jwattsphilly/CE-Senior-Project/README.md

# CE-Senior-Project

Project: Heat map technology for a microwave oven

Authors of this project:
James Watts,
Stuart Johnsen,
Darin Stoker
