jwattsphilly/CE-Senior-Project/Final Report Turnin - Team Smart Microwave/Other Files/Thermal Microwave Presentation.pdf

## A SMARTER MICROWAVE

Stuart Johnsen, Darin Stoker, James Watts

## INTRODUCTION

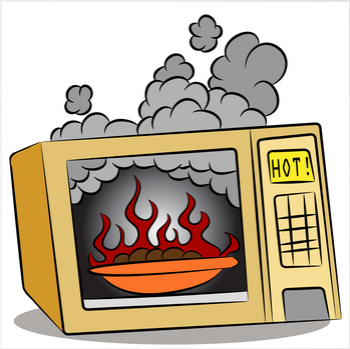
[picture p18: figure]

- Age Old Problem: Lava
Cheese Outside, Ice Cube
in Center
- Old Solution: Nuke it!
- We need a new solution…

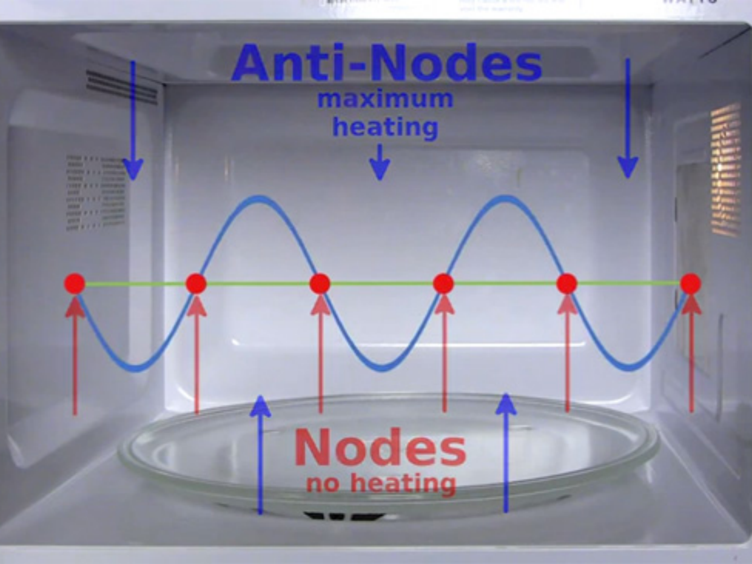
[picture p19: page 3]
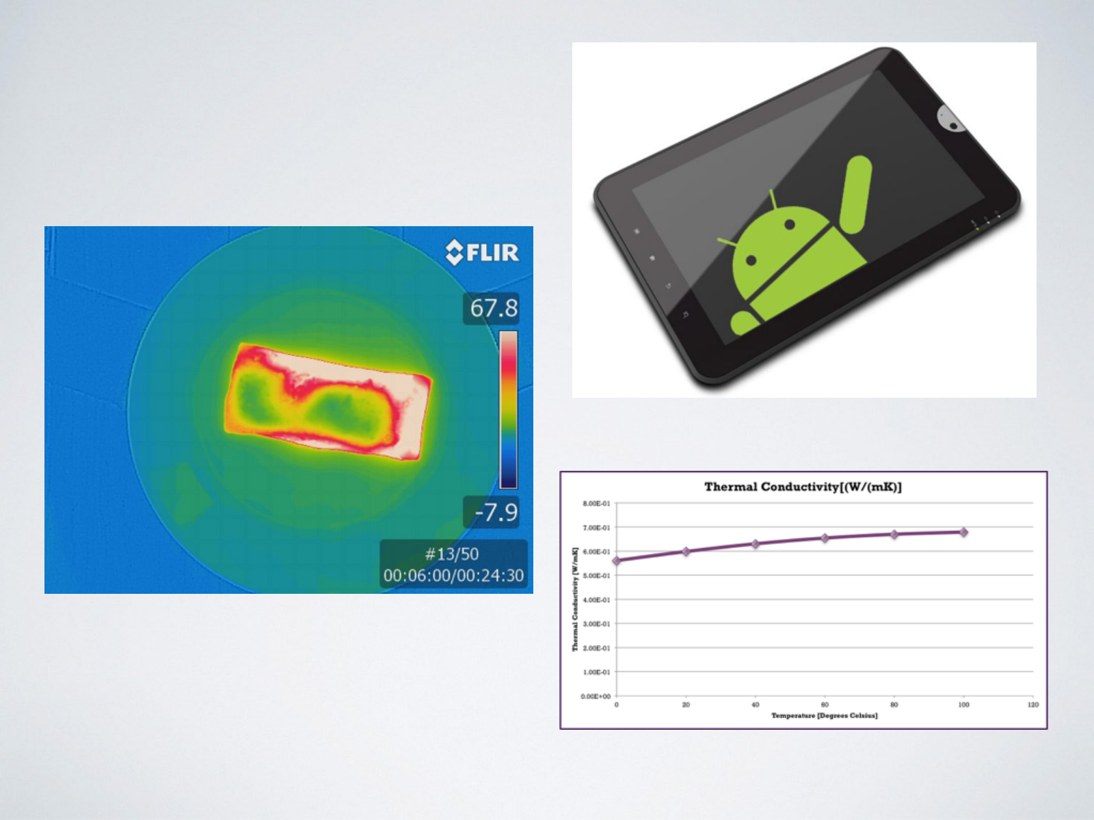
[picture p20: page 4]

## EQUIPMENT NEEDED

- Microwave Oven
- Android Tablet
- Android Studio
- Arduino
- Android-to-Arduino Bridge
- Thermal Camera

## GOAL

- Alter a store-bought microwave so that it can be computer controlled.

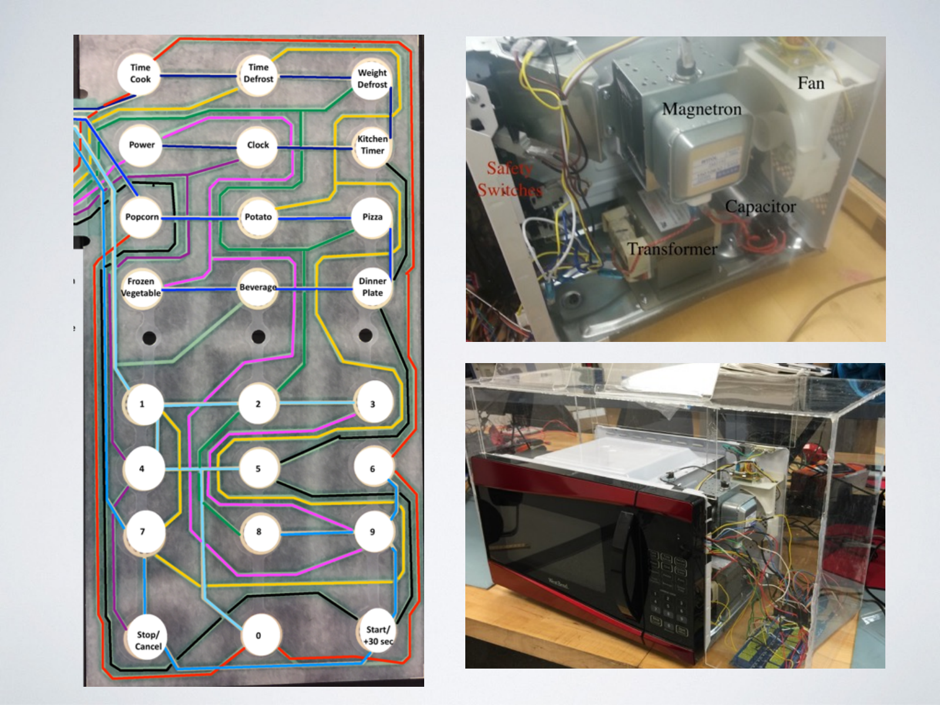
[picture p21: page 7]

## GOAL

- Alter a store-bought microwave so that it can be computer controlled.
- Use UPC (Universal Product Code) scanning to let the microwave know the type of food automatically.

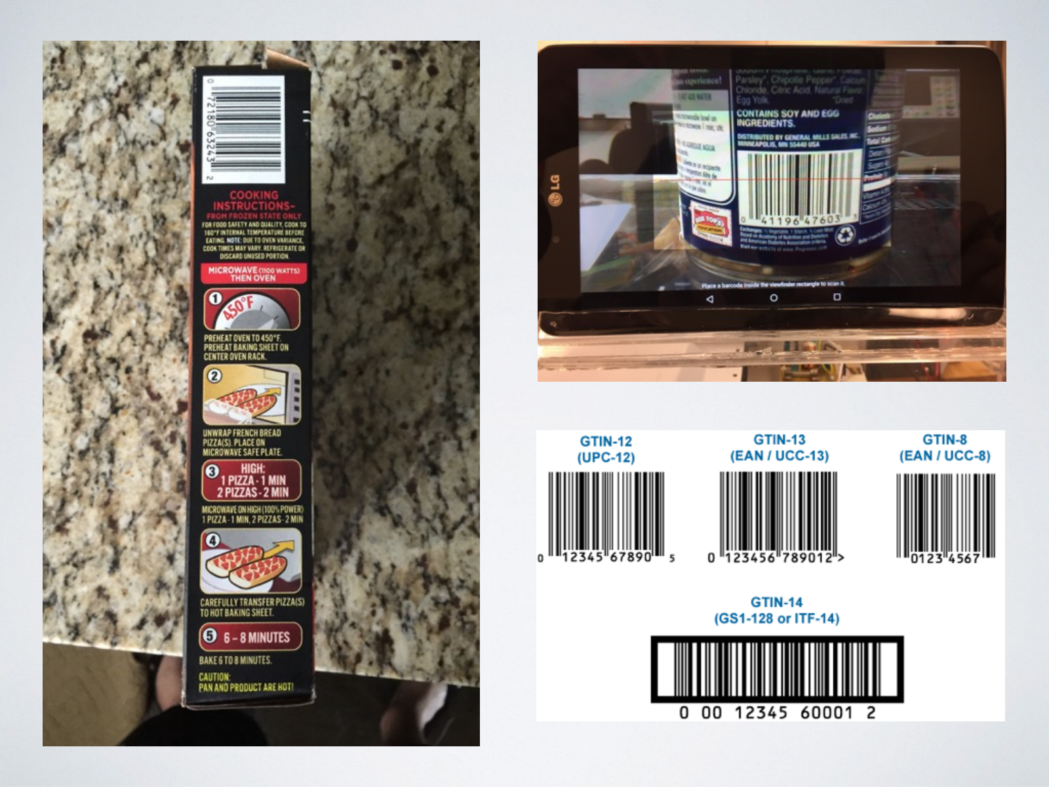
[picture p22: page 9]

## GOAL

- Alter a store-bought microwave so that it can be computer controlled.
- Use UPC (Universal Product Code) scanning to let the microwave know the type of food automatically.
- Actively update a database of food cooking instructions query-able by the microwave.

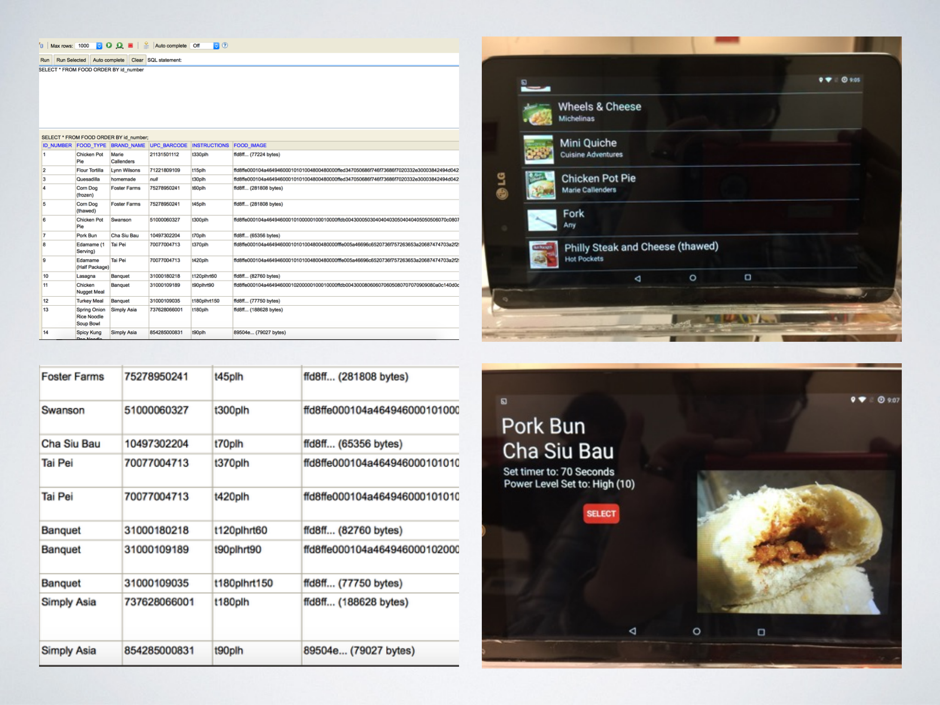
[picture p23: page 11]

## BUT WHAT HAPPENED TO THE THERMAL CAMERA?!?

- A Software Development Kit (SDK) was promised in the summer, but it still hasn’t been delivered.
- Without the camera no live temperature data is available.

## MICROWAVE DEMO

## QUESTIONS?
