jwattsphilly/CE-Senior-Project/Final Report Turnin - Team Smart Microwave/Latex Files/MicrowavePatent.pdf

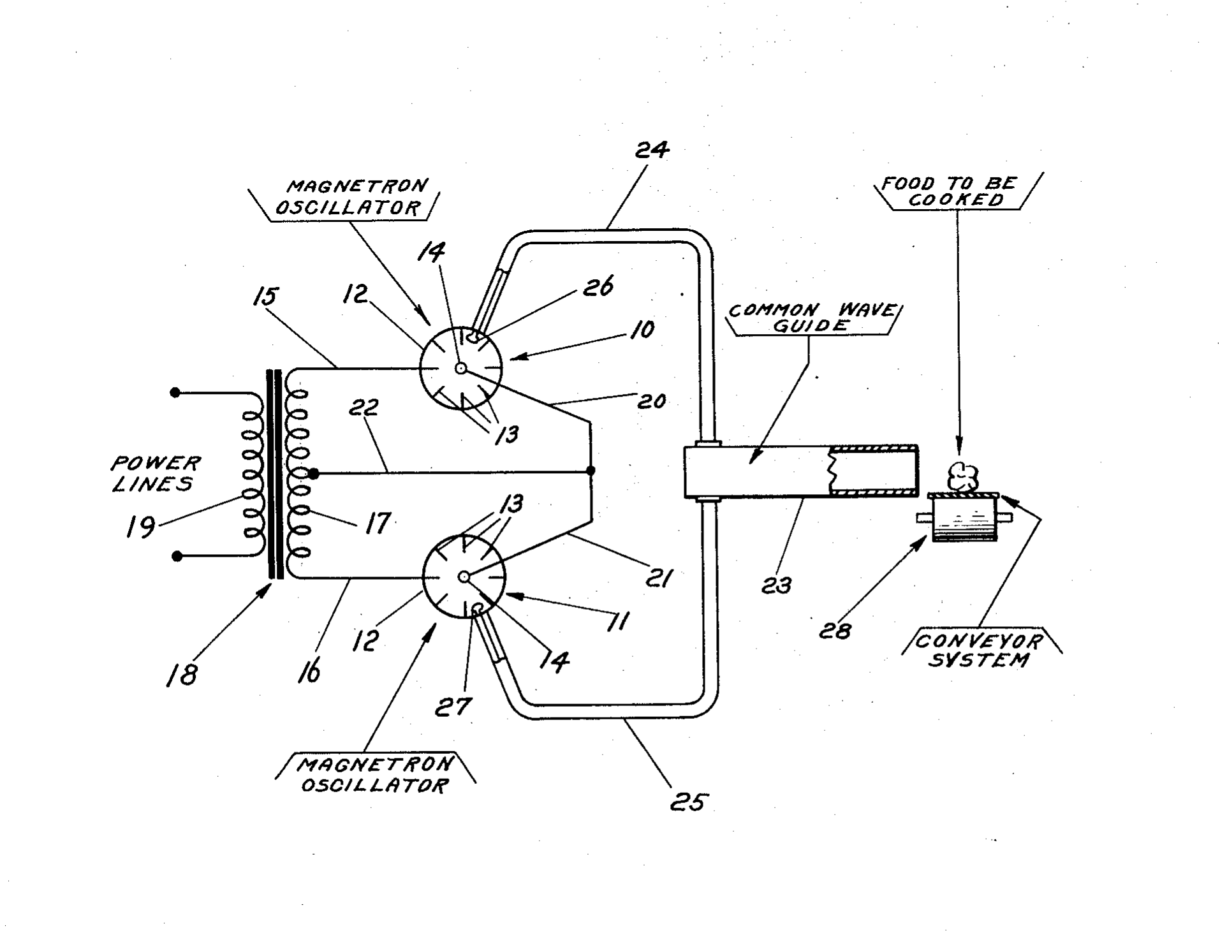
[picture p24: page 1]
