jwattsphilly/CE-Senior-Project/Final Report Turnin - Team Smart Microwave/Other Files/Survey Stats.xlsx

First Review:
Functionality | Satisfaction with Results | User Interface | Overall Satisfaction | Would Want for Oneself | Recommendations |  | Comments
10 | 10 | 10 | 10 | 10 | Thermal Imaging/Image Processing | 6 | Very/Really Cool/Awesome | 4
9 | 9 | 10 | 8 | 3 | User preference/control | 4 | Good Work / Great Job | 3
8 | 6 | 9 | 7 | 5 | Wireless connection / bluetooth | 4 | Great Idea | 3
10 | 10 | 9 | 10 | 8 | Combine touch pad w/ microwave | 2 | Quiche doesn't fare well in microwave | 1
10 | 10 | 10 | 10 | 10 | Quantities of food | 2 | Barcode scanning was cool | 1
9 | 10 | 10 | 10 | 9 | Interface w/ phone - notifications | 2 | Usually don't have barcode | 1
10 | 10 | 10 | 10 | 10 | Altitude, Barometric pressure | 2 | How does thermal imaging improve overall users needs? | 1
9 | 9 | 9 | 9 | 9 | Multiple cooking options | 1 | Practical | 1
10 | 10 | 10 | 10 | 10 | Leaving comments/ratings | 1 | No problems | 1
8 | 8 | 7 | 8 | 6 | Put food in microwave for you | 1 | Wouldn't want to pay a lot more for this functionality | 1
7 | 9 | 10 | 10 | 6 | Show partial search results | 1
9 | 9 | 7 | 9 | 10 | Better looking app | 1
10 | 8 | 10 | 9 | 7 | Nutrition facts | 1
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
