jwattsphilly/CE-Senior-Project/App Design.JPG

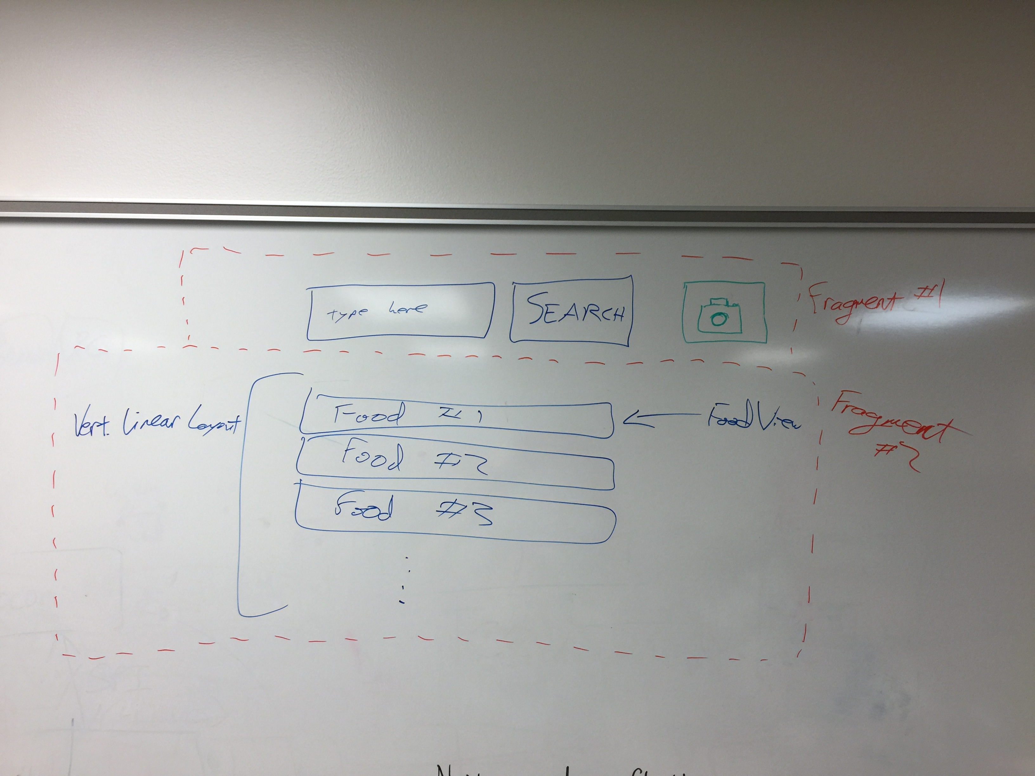
App Design.JPG
