jwattsphilly/CE-Senior-Project/Final Report Turnin - Team Smart Microwave/Latex Files/Microwave_Motor_1.jpg

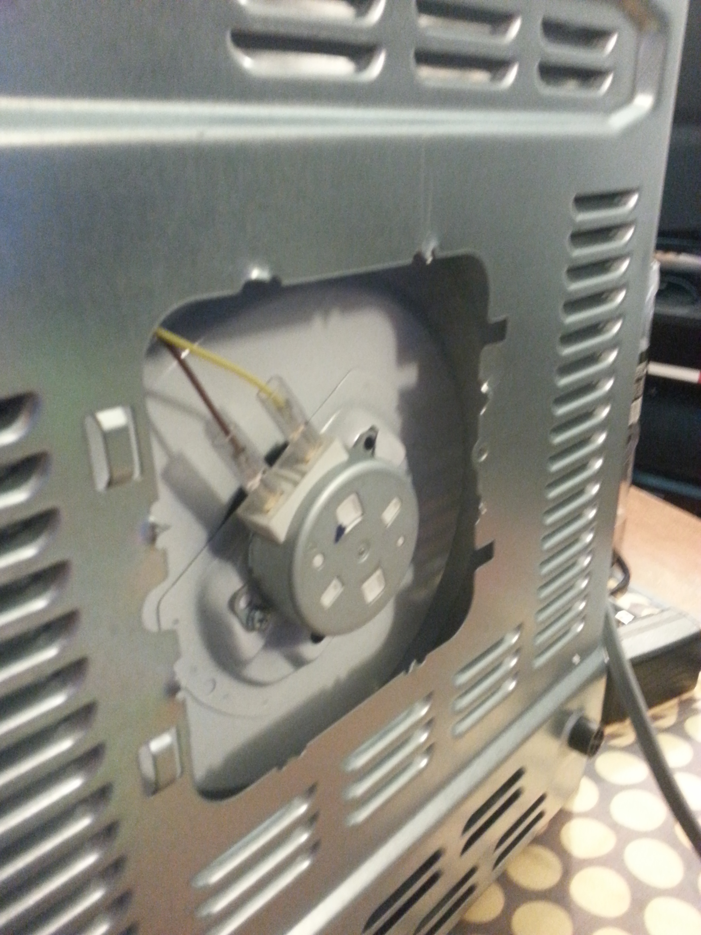
Final Report Turnin - Team Smart Microwave/Latex Files/Microwave_Motor_1.jpg
