jwattsphilly/CE-Senior-Project/Microcontroller Pinout.png

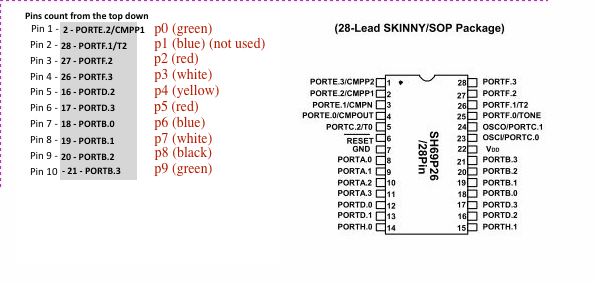
Microcontroller Pinout.png
