jwattsphilly/CE-Senior-Project/Microwave Activity Map.jpg

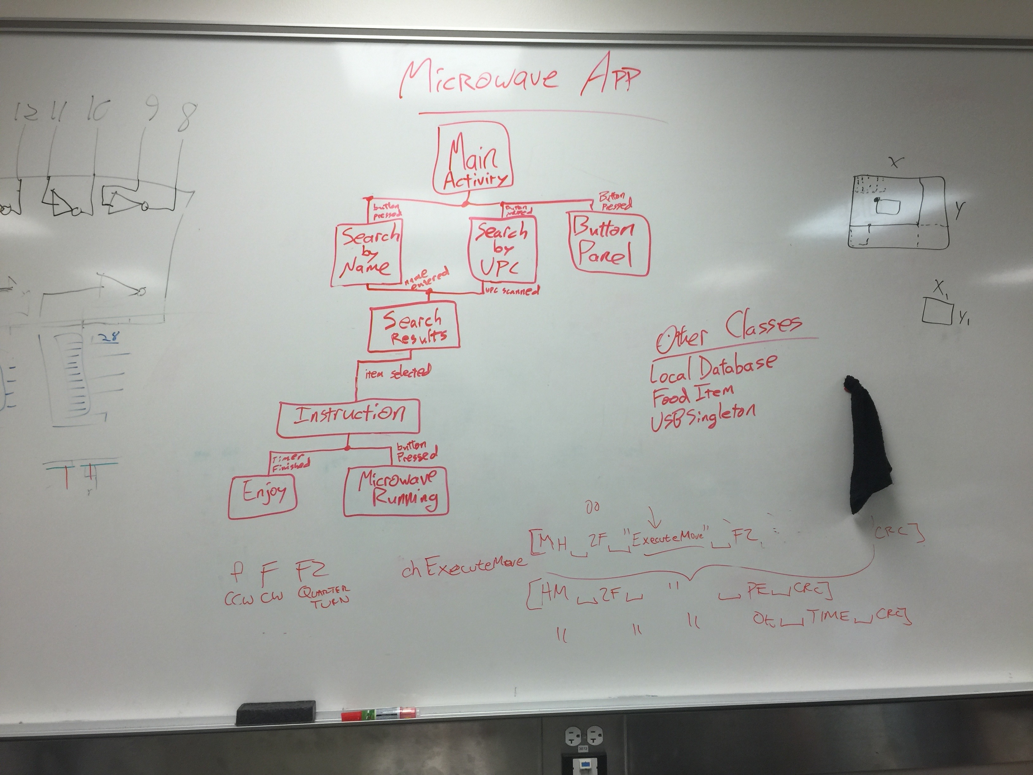
Microwave Activity Map.jpg
