jwattsphilly/CE-Senior-Project/Audio data transfer/Instructable/tek00000.png

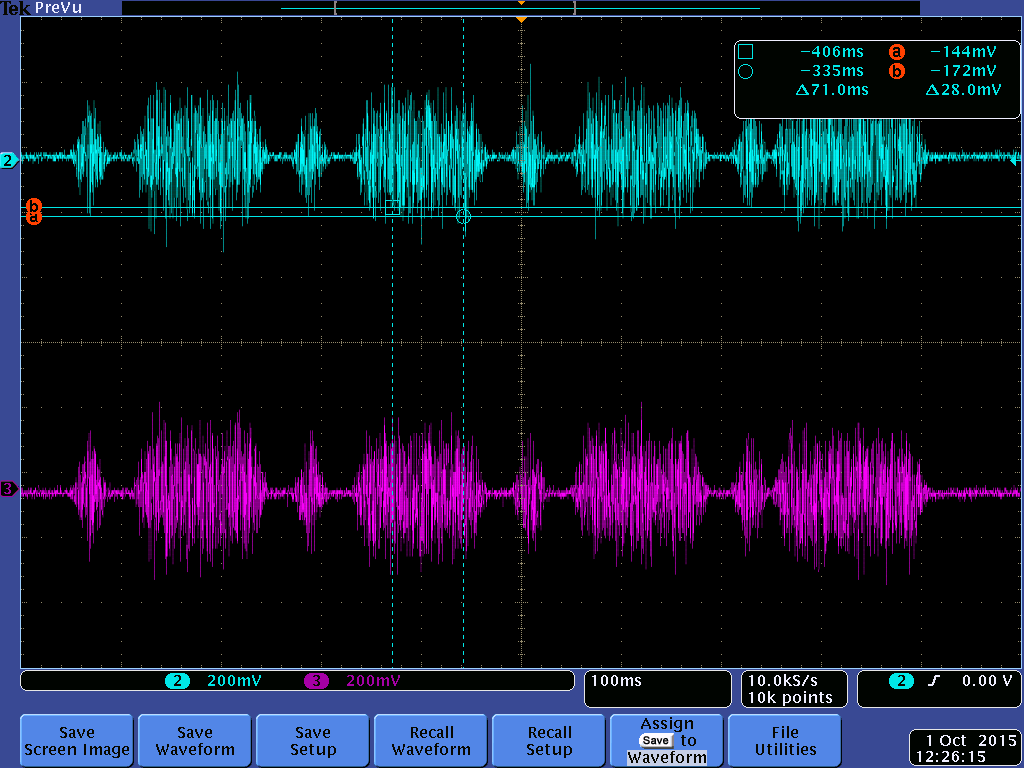
Audio data transfer/Instructable/tek00000.png
