jwattsphilly/CE-Senior-Project/Final Report Turnin - Team Smart Microwave/Construction Images/Arduino and Relay Board.jpg

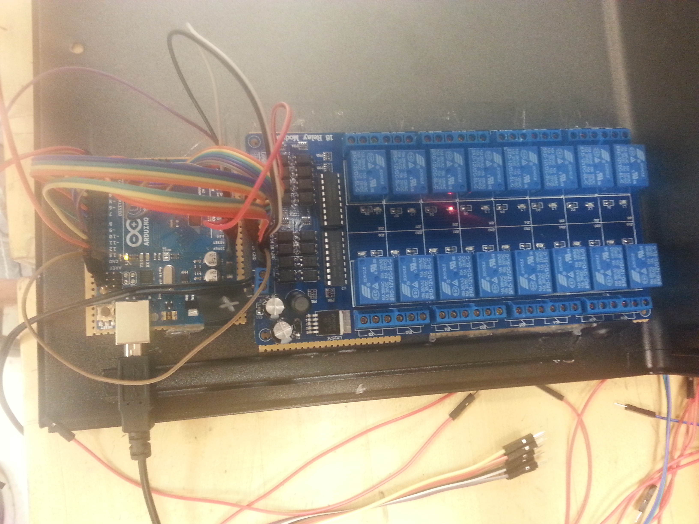
Final Report Turnin - Team Smart Microwave/Construction Images/Arduino and Relay Board.jpg
