jwattsphilly/CE-Senior-Project/Final Report Turnin - Team Smart Microwave/Construction Images/Microwave Motor Bottom.jpg

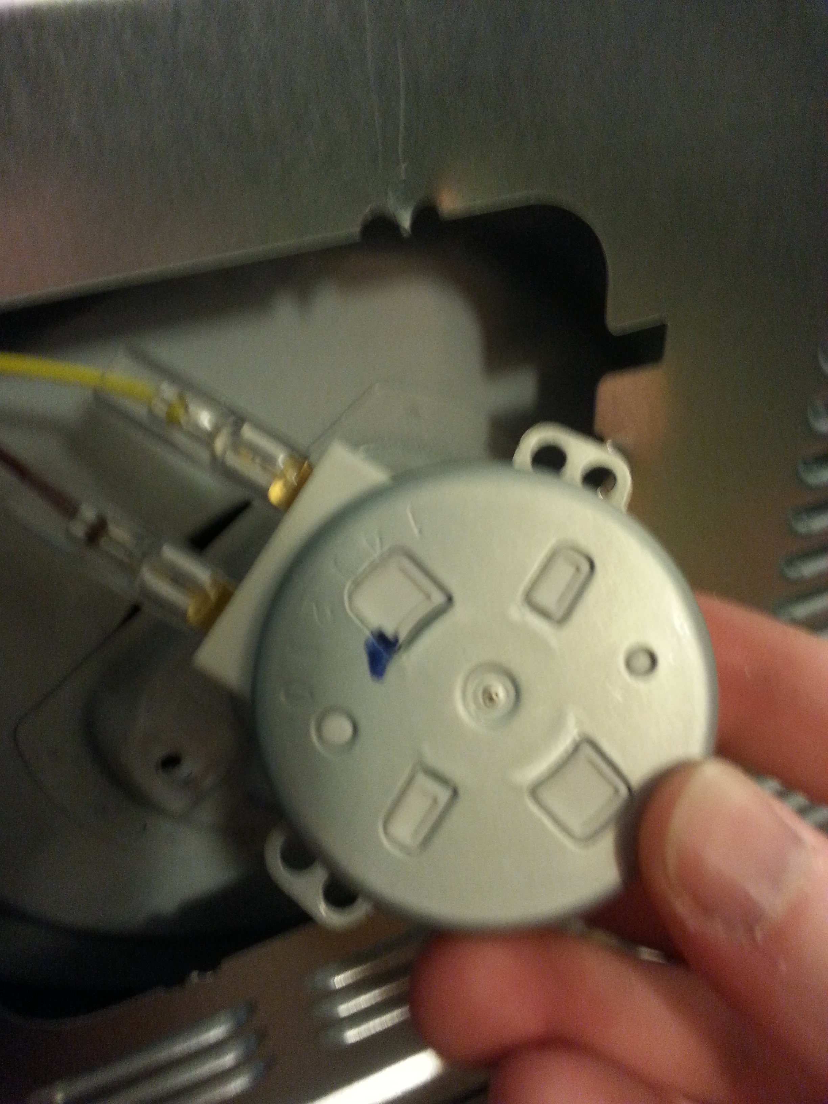
Final Report Turnin - Team Smart Microwave/Construction Images/Microwave Motor Bottom.jpg
