jwattsphilly/CE-Senior-Project/Final Report Turnin - Team Smart Microwave/Construction Images/Microwave Motor Top.jpg

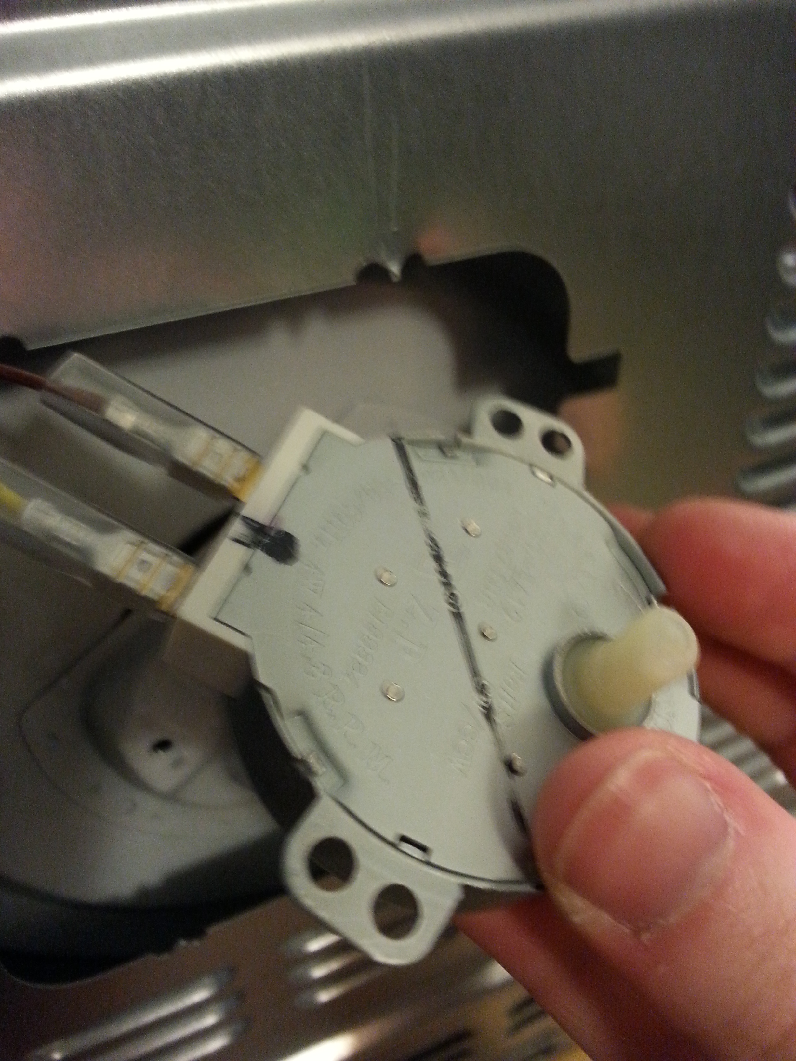
Final Report Turnin - Team Smart Microwave/Construction Images/Microwave Motor Top.jpg
