jwattsphilly/CE-Senior-Project/Final Report Turnin - Team Smart Microwave/Latex Files/Complete_Build.JPG

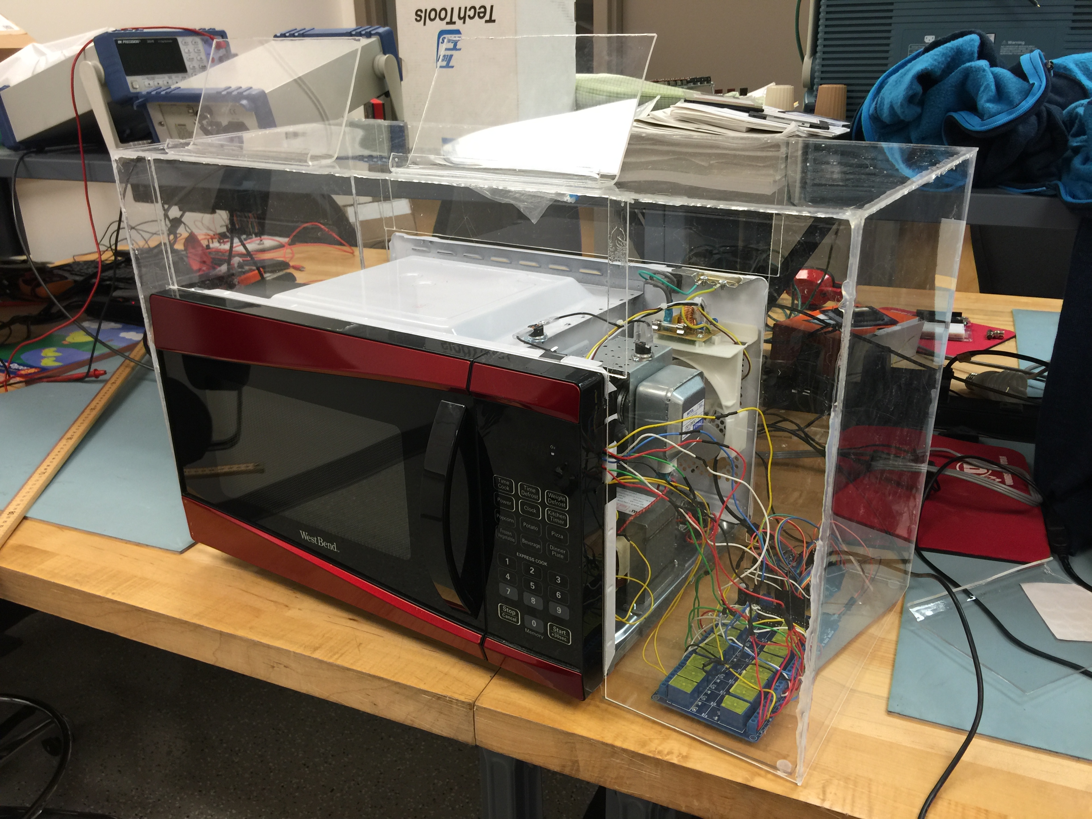
Final Report Turnin - Team Smart Microwave/Latex Files/Complete_Build.JPG
