jwattsphilly/CE-Senior-Project/Final Report Turnin - Team Smart Microwave/Latex Files/HardwareBuild.JPG

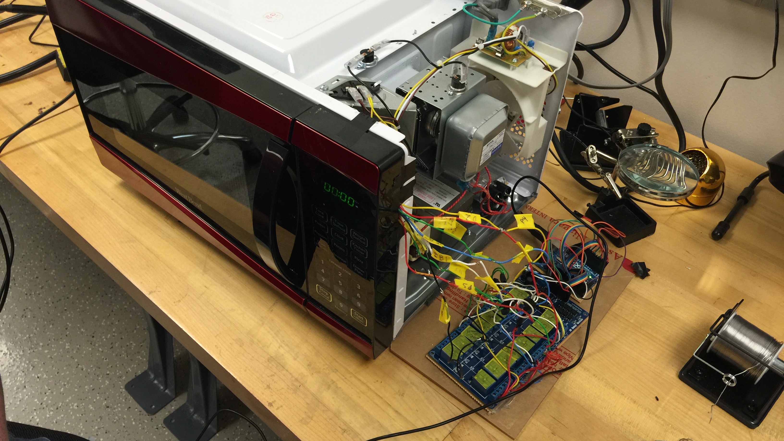
Final Report Turnin - Team Smart Microwave/Latex Files/HardwareBuild.JPG
