jwattsphilly/CE-Senior-Project/(commit log)

2015-05-09 Added Gantt chart for reporting progress
    [Project Schedule.xlsx]
2015-05-15 Added the button multiplex image.
2015-05-27 Updated weekly log and added documentation on the button matrix.
2015-06-04 Converted Button Matrix.rtf to a plain text file
2015-06-11 Added Arduino code. We can now simulate button presses through serial communication. :)
2015-07-20 Added pictures of the microwave motor
2015-08-06 Added wait functionality to Arduino code
2015-09-24 Updated Arduino code
2015-09-28 Put in example Arduino code
2015-10-01 txt version of arduino file with decoded var names
2015-10-15 Android to Arduino USB Protocol! Yay!!!
2015-10-20 my usb to arduino test files
2015-10-22 The tablet app now communicates properly with the microwave! Yay! We do have the issue that the timers aren't synced, but we have a plan for that. Updated the log and sent it to Ken.
2015-10-27 Timers should be about synchronized now...hopefully
2015-10-27 Temp plate button added for testing with arduino code changes.
2015-11-03 Fixed microwave manual control and added new buttons. Tried to update tablet, but the update failed. Got it back online and tested again. Updated Arduino code for the plate toggle.
    [MicrowaveRelay.ino]
2015-11-07 Started timer code for Manual Microwave Control
2015-11-09 Timer in Manual Microwave Control should be fully functional
2015-11-10 Timer definitely working!
2015-11-13 Fixed threading issues. Added motor control to MicrowaveRunning & Enjoy activities.
2015-11-13 Updated visual styles on most of the elements. There seems to be an issue with the USB singleton. It works fine when connected to a real Android phone, but the virtual ones are failing. I did create 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
2015-11-19 Fixed myriad small problems, including making the USB send method synchronous. This seems to have resolved the microwave disconnect problem.
    [MicrowaveRelay.ino]
2015-11-24 Fixed issue in state machine for Manual Microwave Control; Fan stuff works
2015-11-24 Added fan control to Arduino.
2015-11-24 Fixed the "Doh" message visual style. Made it so that arduino USB reconnection will reflect in the LED blink.
    [MicrowaveRelay.ino]
2015-12-01 Secret Timer added
2015-12-02 Added spreadsheet of survey stats.
    [Survey Stats.xlsx]
2015-12-15 Updated Button Matrix.txt to include fan and LED
2015-12-15 Added Activity Flow image.
2015-12-19 Just need final report in turn-in folder, and we'll be good to go.
    [Survey Stats.xlsx]
